Staok/buck-cc-cv/原理图-PCB-VOL.2/PCB-3D-2.png

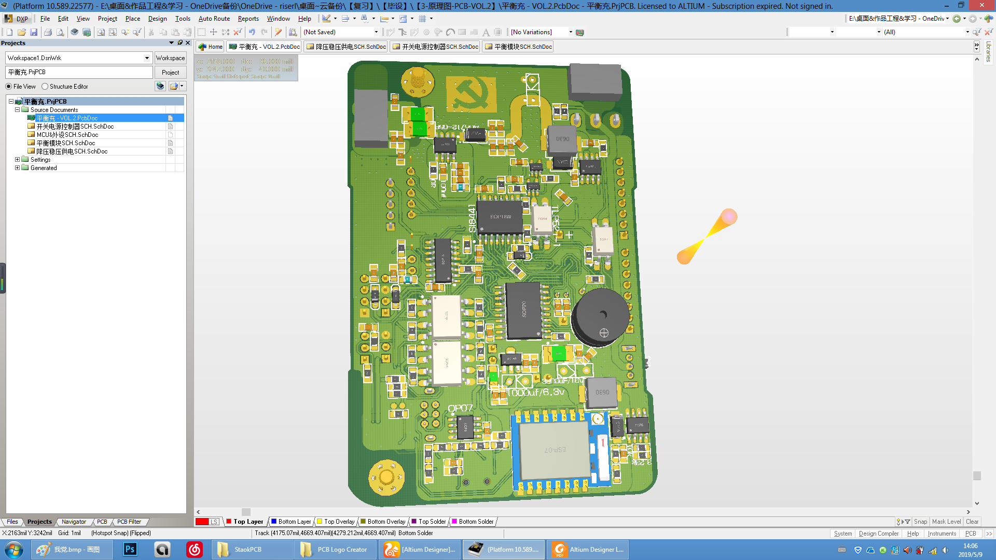
原理图-PCB-VOL.2/PCB-3D-2.png
