Staok/buck-cc-cv/README.md

# BUCK_CC-CV
 一个实现了较高质量的BUCK恒压恒流源

文件介绍：

- 程序工程：无RTOS、无GUI，STM32F1芯片，MDK5开发环境，程序架构按照“说明文件”里面的“计划.txt”做的，~~简单的一批~~，都3000多行了。
- 说明文件：包括PPT项目介绍，项目摘要，锂电池充电流程自制图，本项目硬件框架图和软件菜单设计图等。
- 原理图：原理图，随便看，我不告诉你这个原理图的电流采集部分不是真实用到的。
