Staok/buck-cc-cv/说明文件/2、电源管理方案框架示意图-VOL.2-A2.pdf

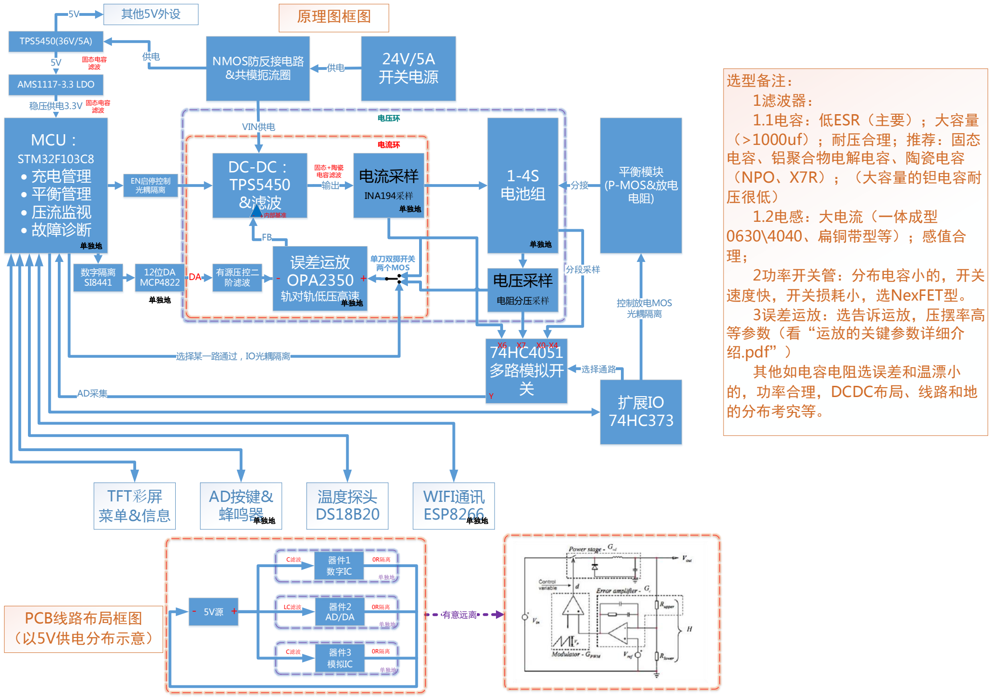
[picture p3: page 1]

选型备注：
1滤波器：
1.1电容：低ESR（主要）；大容量
（>1000uf）；耐压合理；推荐：固态
电容、铝聚合物电解电容、陶瓷电容
（NPO、X7R）；（大容量的钽电容耐
压很低）
1.2电感：大电流（一体成型
0630\4040、扁铜带型等）；感值合
理；
2功率开关管：分布电容小的，开关
速度快，开关损耗小，选NexFET型。
3误差运放：选告诉运放，压摆率高
等参数（看“运放的关键参数详细介
绍.pdf”）
其他如电容电阻选误差和温漂小
的，功率合理，DCDC布局、线路和地
的分布考究等。

PCB线路布局框图
（以5V供电分布示意）

器件1
数字IC
- 5V源 +

LC滤波

C滤波

C滤波

0R隔离

器件2
AD/DA

器件3
模拟IC

0R隔离

0R隔离

有意远离

平衡模块
(P-MOS&放电
电阻)

NMOS防反接电路
&共模扼流圈

电压采样

电阻分压采样

输出

VIN供电

供电

AD采集

电流环

TFT彩屏
菜单&信息

温度探头
DS18B20

DA

TPS5450(36V/5A)

AMS1117-3.3 LDO

稳压供电3.3V

5V

电压环

5V | 其他5V外设

24V/5A
开关电源 供电

EN启停控制
光耦隔离 | 分接

固态电容
滤波

固态电容
滤波

固态+陶瓷
电容滤波

FB

扩展IO
74HC373

控制放电MOS
光耦隔离

选择某一路通过，IO光耦隔离

DC-DC：
TPS5450

&滤波- +内部基准

数字隔离
SI8441

有源压控二
阶滤波

单刀双掷开关
两个MOS | 分段采样

74HC4051
多路模拟开
Y | 关
X6 | X7 | X0-X4

选择通路

AD按键&

蜂鸣器单独地

WIFI通讯
ESP8266单独地

MCU：

STM32F103C8
- 充电管理
- 平衡管理
- 压流监视
- 故障诊断

单独地

12位DA
MCP4822

单独地

误差运放
OPA2350
轨对轨低压高速
- +

单独地

1-4S
电池组

单独地

电流采样

INA194采样

单独地

原理图框图

单独地

单独地

单独地
