Staok/buck-cc-cv/说明文件/1、充电流程图-A2.pdf

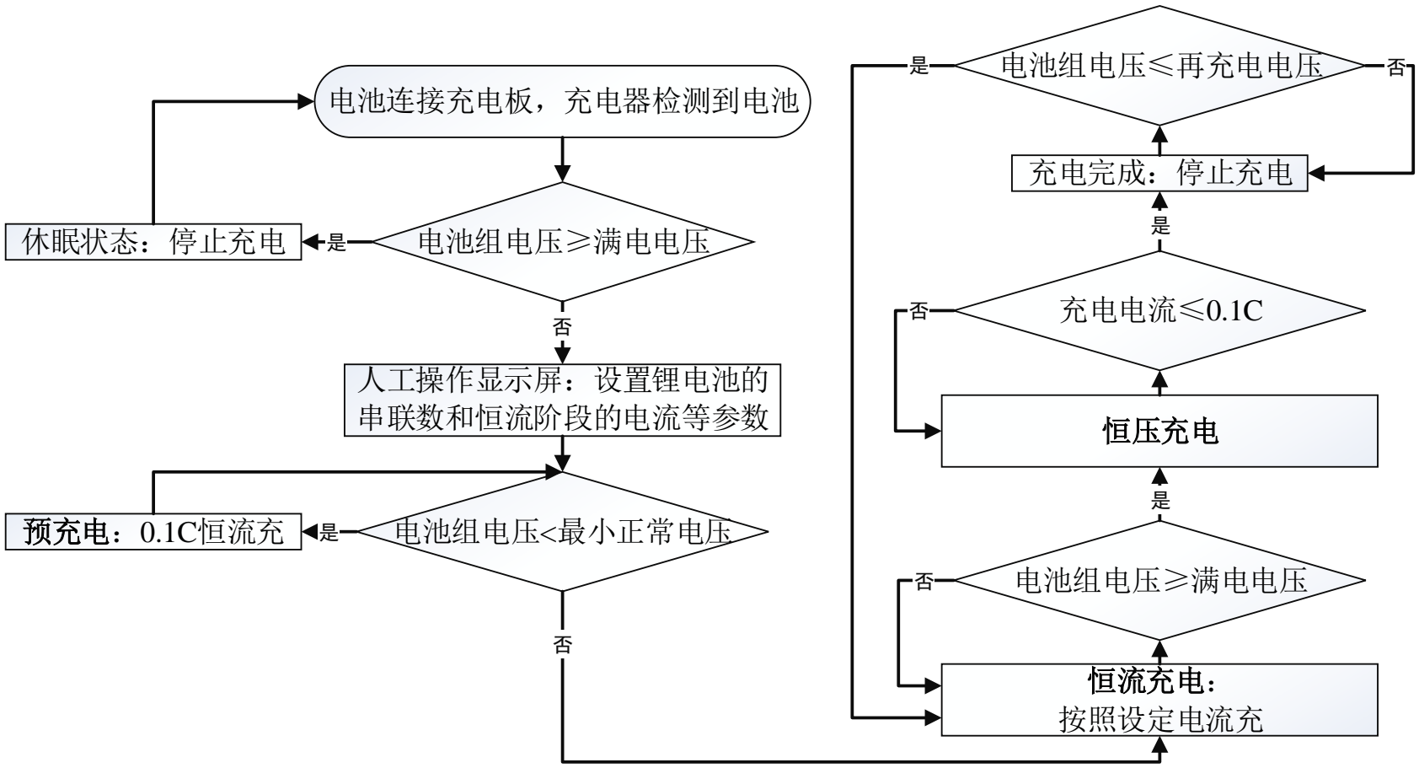
[picture p4: figure]
电池连接充电板，充电器检测到电池; 电池组电压≥满电电压; 人工操作显示屏：设置锂电池的 串联数和恒流阶段的电流等参数; 休眠状态：停止充电; 预充电：0.1C恒流充; 电池组电压<最小正常电压; 恒流充电： 按照设定电流充; 恒压充电; 充电电流≤0.1C; 充电完成：停止充电; 电池组电压≤再充电电压
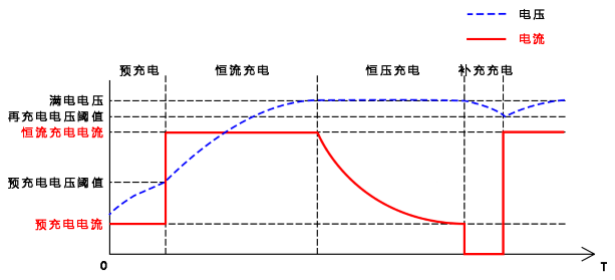
[picture p5: figure]
