Staok/buck-cc-cv/原理图-PCB-VOL.2/充电模式_小图.jpg

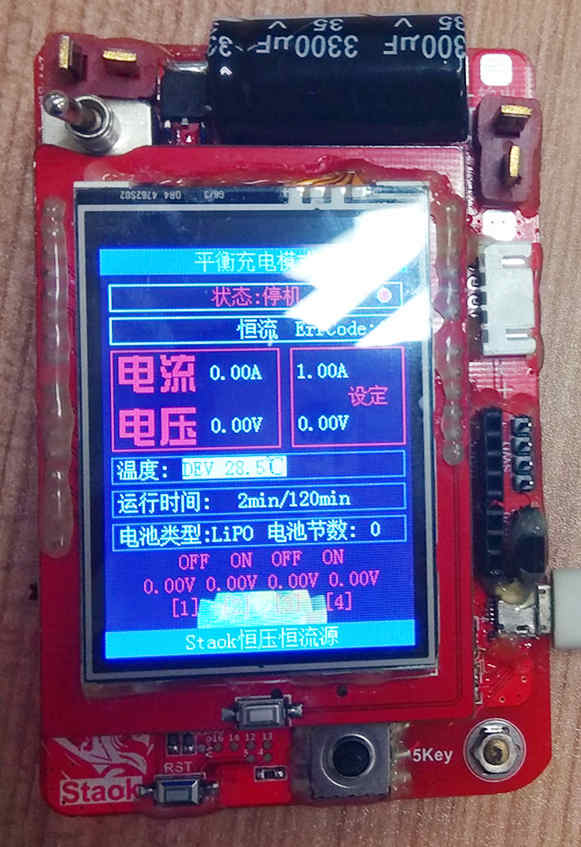
原理图-PCB-VOL.2/充电模式_小图.jpg
