Staok/buck-cc-cv/原理图-PCB-VOL.2/历史设计和其他参考/2.4寸UNO模块尺寸图.png

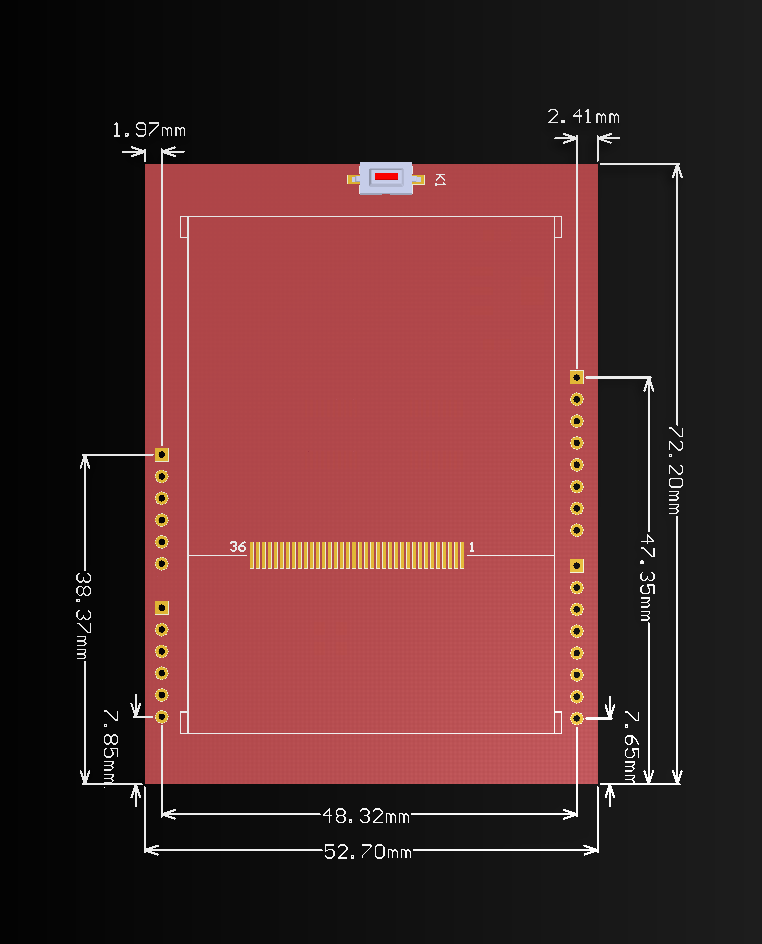
原理图-PCB-VOL.2/历史设计和其他参考/2.4寸UNO模块尺寸图.png
