Staok/buck-cc-cv/原理图-PCB-VOL.2/历史设计和其他参考/初代 vol.2.png

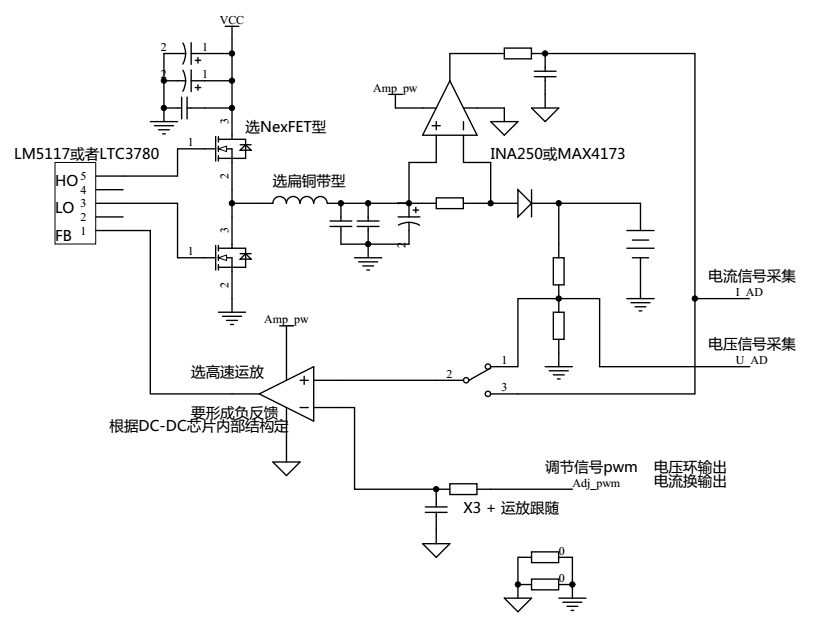
原理图-PCB-VOL.2/历史设计和其他参考/初代 vol.2.png
