Staok/buck-cc-cv/原理图-PCB-VOL.2/原理图-纠正防反接电路.png

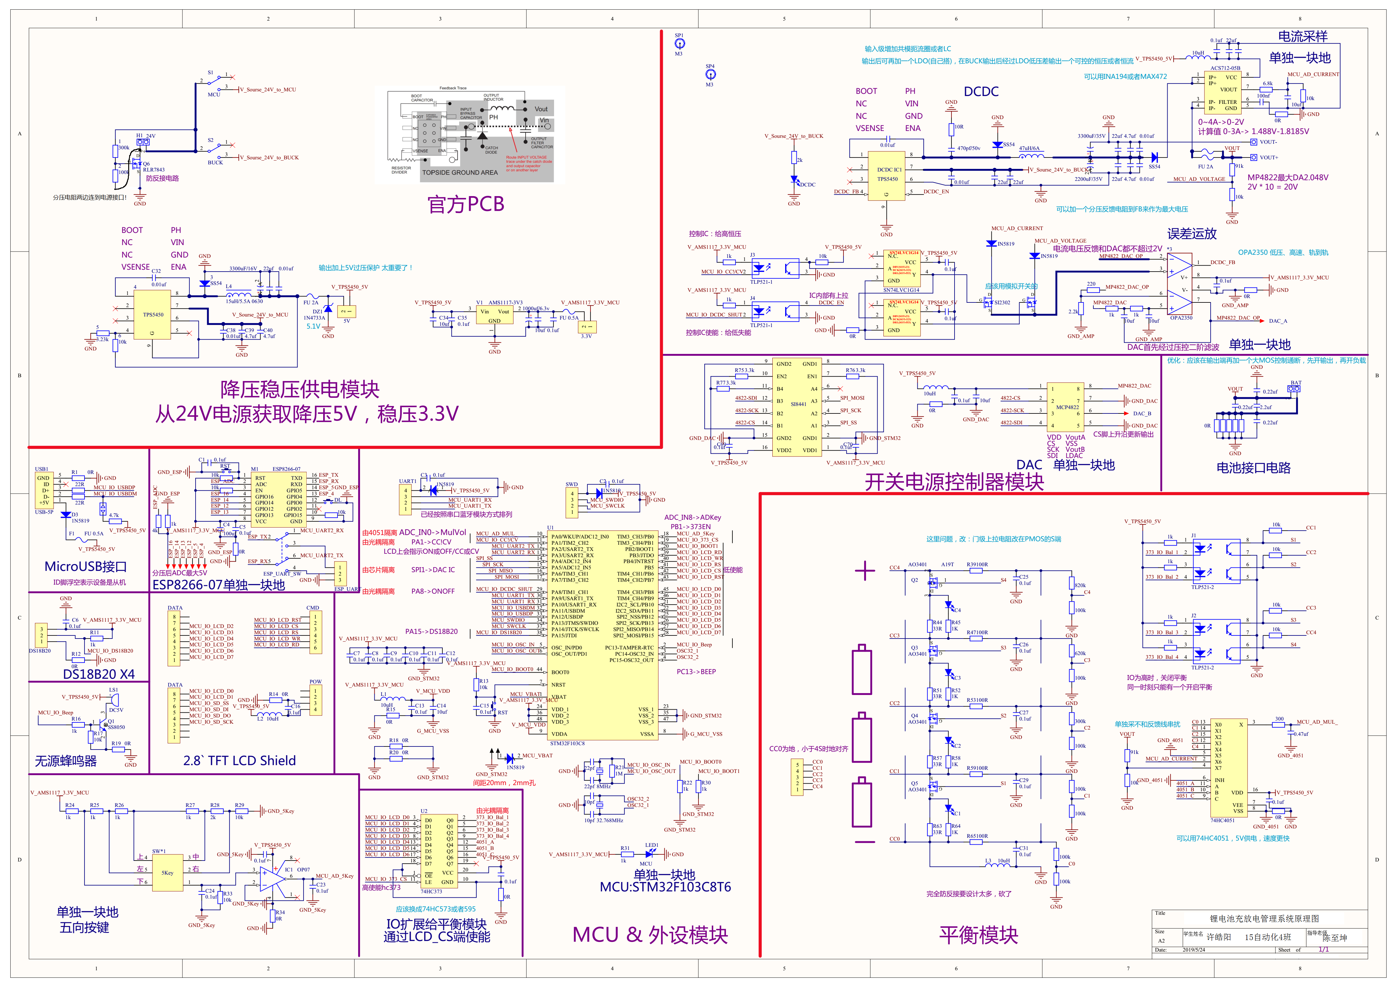
原理图-PCB-VOL.2/原理图-纠正防反接电路.png
