Staok/buck-cc-cv/说明文件/4、有源压控二阶滤波和有源一阶滤波对比-A3.png

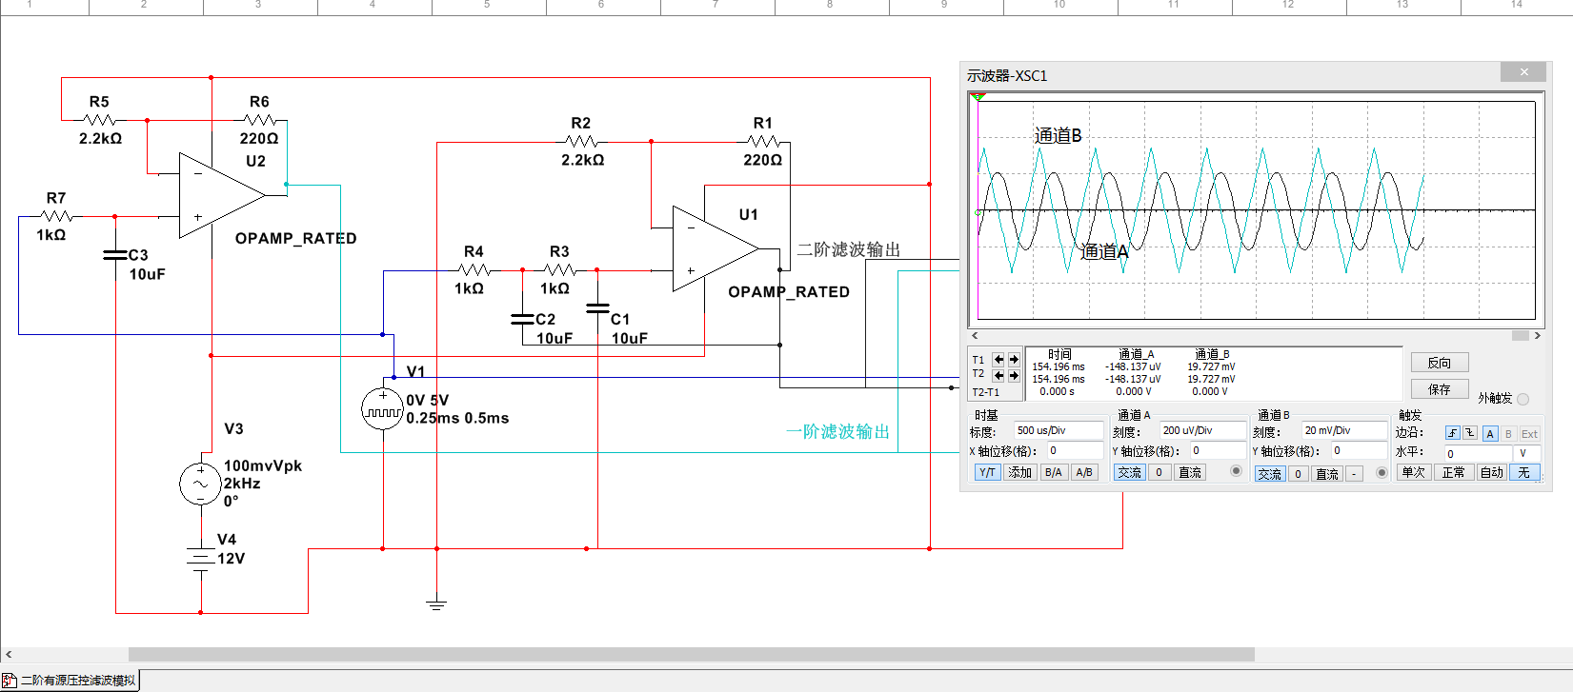
说明文件/4、有源压控二阶滤波和有源一阶滤波对比-A3.png
