Staok/buck-cc-cv/说明文件/5、菜单操作流程-A2.pdf

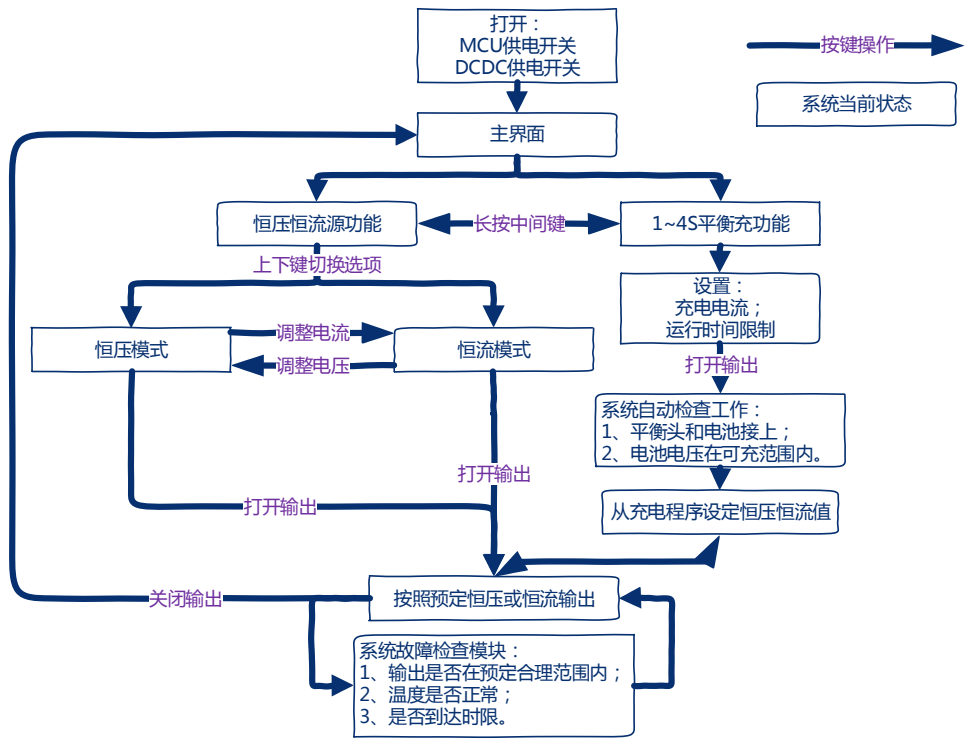
[picture p13: page 1]
打开： MCU供电开关 DCDC供电开关; 主界面; 恒压恒流源功能; 长按中间键; 1~4S平衡充功能; 恒压模式; 恒流模式; 按照预定恒压或恒流输出; 系统自动检查工作： 1、平衡头和电池接上； 2、电池电压在可充范围内。; 上下键切换选项; 调整电流; 设置： 充电电流； 运行时间限制; 调整电压; 打开输出; 系统故障检查模块： 1、输出是否在预定合理范围内； 2、温度是否正常； 3、是否到达时限。; 关闭输出; 从充电程序设定恒压恒流值; 按键操作; 系统当前状态
