Staok/buck-cc-cv/原理图-PCB-VOL.2/历史设计和其他参考/平衡充初代结构图.pdf

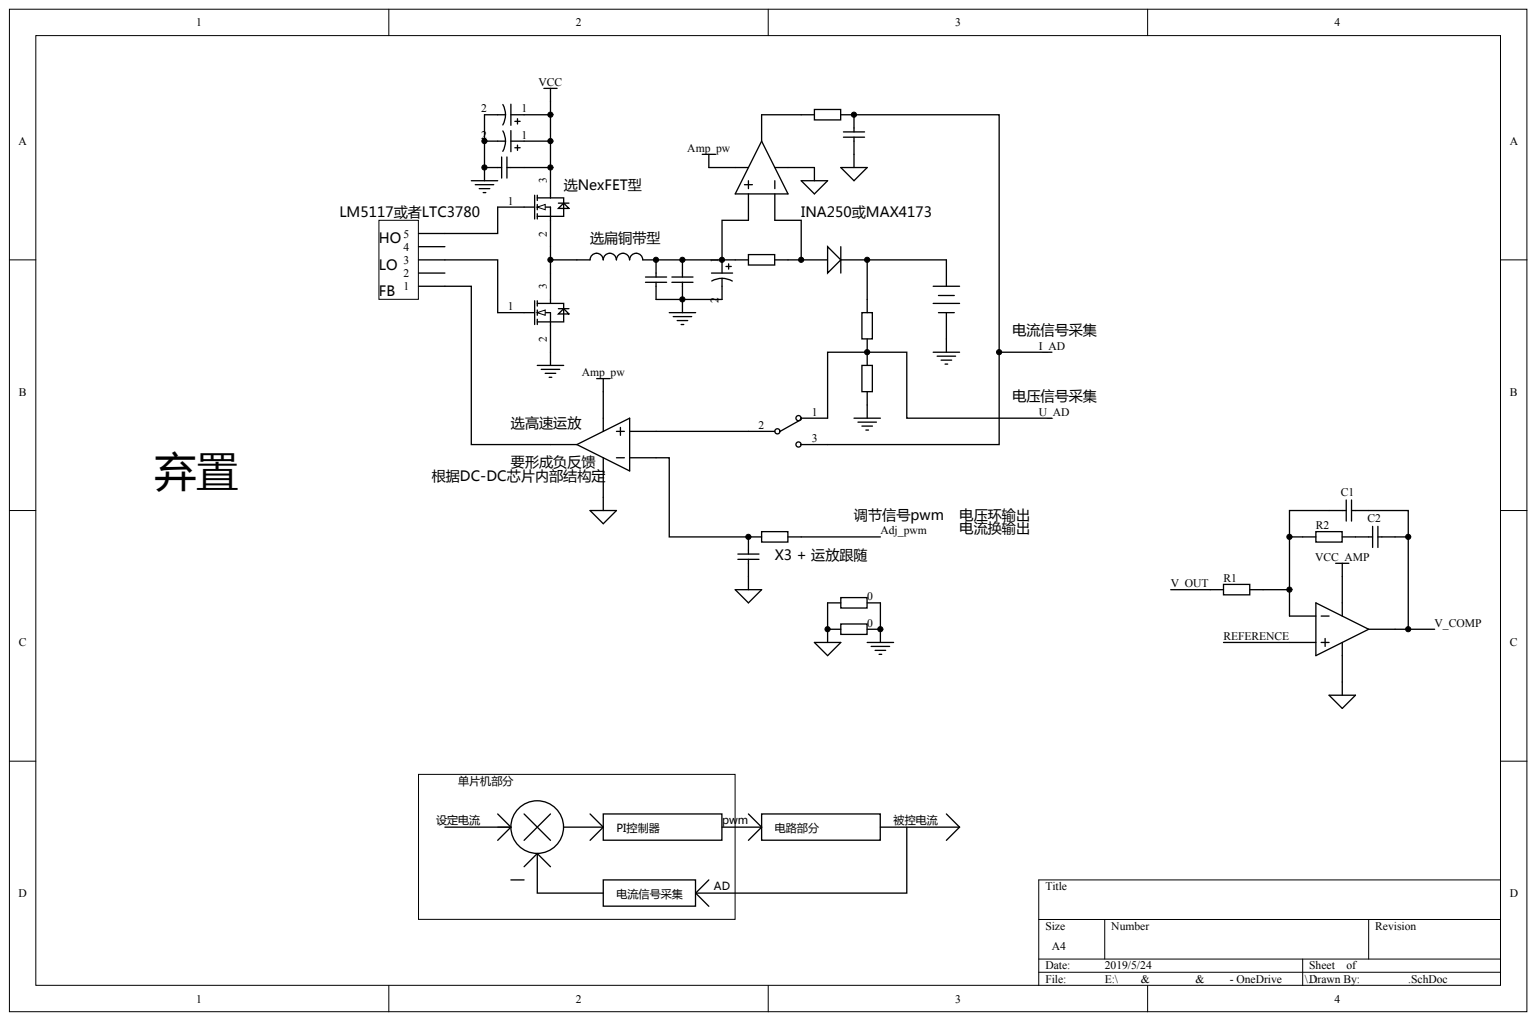
[picture p14: page 1]
