Staok/buck-cc-cv/(list of files, drawings)

Other design files:
原理图-PCB-VOL.2/MCU&外设SCH.SchDoc
原理图-PCB-VOL.2/历史设计和其他参考/平衡充初代结构图.SchDoc
原理图-PCB-VOL.2/历史设计和其他参考/开关控制器SCH.SchDoc
原理图-PCB-VOL.2/平衡模块SCH.SchDoc
原理图-PCB-VOL.2/开关电源控制器SCH.SchDoc
原理图-PCB-VOL.2/降压稳压供电SCH.SchDoc
