Staok/buck-cc-cv/程序工程/HARDWARE/ADC/adc.c

 #include "adc.h"
 #include "delay.h"
//////////////////////////////////////////////////////////////////////////////////	 
//本程序只供学习使用，未经作者许可，不得用于其它任何用途
//Mini STM32开发板
//ADC 驱动代码			   
//正点原子@ALIENTEK
//技术论坛:www.openedv.com
//修改日期:2010/6/7 
//版本：V1.0
//版权所有，盗版必究。
//Copyright(C) 正点原子 2009-2019
//All rights reserved					   
//////////////////////////////////////////////////////////////////////////////////	 
 
		   
//初始化ADC，学一学ADC->DMA多省时间
//这里我们仅以规则通道为例
//我们默认将开启通道0~3																	   
void  Adc_Init(void)
{ 	
	ADC_InitTypeDef ADC_InitStructure; 
	GPIO_InitTypeDef GPIO_InitStructure;
	RCC_APB2PeriphClockCmd(RCC_APB2Periph_GPIOA | RCC_APB2Periph_GPIOB | RCC_APB2Periph_ADC1, ENABLE );//使能ADC1通道时钟
 
	RCC_APB2PeriphResetCmd(RCC_APB2Periph_ADC1,ENABLE);	//ADC1复位
	RCC_APB2PeriphResetCmd(RCC_APB2Periph_ADC1,DISABLE);//ADC1复位借宿

	RCC_ADCCLKConfig(RCC_PCLK2_Div6);   //72M/6=12,ADC最大时间不能超过14M
	//PA0 作为模拟通道输入引脚                         
	GPIO_InitStructure.GPIO_Pin = GPIO_Pin_0;
	GPIO_InitStructure.GPIO_Mode = GPIO_Mode_AIN;		//模拟输入引脚
	GPIO_Init(GPIOA, &GPIO_InitStructure);
    //PB0 作为模拟通道输入引脚
    GPIO_InitStructure.GPIO_Pin = GPIO_Pin_0;
    GPIO_InitStructure.GPIO_Mode = GPIO_Mode_AIN;//PB0对应ADKey
    GPIO_Init(GPIOB, &GPIO_InitStructure);

	ADC_DeInit(ADC1);  //将外设 ADC1 的全部寄存器重设为缺省值

	ADC_InitStructure.ADC_Mode = ADC_Mode_Independent;	//ADC工作模式:ADC1工作在独立模式
	ADC_InitStructure.ADC_ScanConvMode = DISABLE;	//模数转换工作在单通道模式
	ADC_InitStructure.ADC_ContinuousConvMode = DISABLE;	//模数转换工作在单次转换模式
	ADC_InitStructure.ADC_ExternalTrigConv = ADC_ExternalTrigConv_None;	//转换由软件而不是外部触发启动
	ADC_InitStructure.ADC_DataAlign = ADC_DataAlign_Right;	//ADC数据右对齐
	ADC_InitStructure.ADC_NbrOfChannel = 1;	//顺序进行规则转换的ADC通道的数目
	ADC_Init(ADC1, &ADC_InitStructure);	//根据ADC_InitStruct中指定的参数初始化外设ADCx的寄存器   

  //	ADC_RegularChannelConfig(ADC1, ADC_Channel_1, 1, ADC_SampleTime_239Cycles5);  //ADC规则序列配置
    ADC_TempSensorVrefintCmd(ENABLE); //开启内部温度传感器
	ADC_Cmd(ADC1, ENABLE);	//使能指定的ADC1
    
	ADC_ResetCalibration(ADC1);	//重置指定的ADC1的校准寄存器
	while(ADC_GetResetCalibrationStatus(ADC1));	//获取ADC1重置校准寄存器的状态,设置状态则等待
	ADC_StartCalibration(ADC1);		//开始指定ADC1的校准状态
	while(ADC_GetCalibrationStatus(ADC1));		//获取指定ADC1的校准程序,设置状态则等待
	//ADC_SoftwareStartConvCmd(ADC1, ENABLE);		//使能指定的ADC1的软件转换启动功能

}				  
//获得ADC值
//ch:通道值 0~3
u16 Get_Adc(u8 ch)   
{
  	//设置指定ADC的规则组通道，设置它们的转化顺序和采样时间
	ADC_RegularChannelConfig(ADC1, ch, 1, ADC_SampleTime_239Cycles5 );	//ADC1,ADC通道,规则采样顺序值为1,采样时间为239.5周期
	ADC_SoftwareStartConvCmd(ADC1, ENABLE);		//使能指定的ADC1的软件转换启动功能	
	while(!ADC_GetFlagStatus(ADC1, ADC_FLAG_EOC ));//等待转换结束
	return ADC_GetConversionValue(ADC1);	//返回最近一次ADC1规则组的转换结果
}

u16 Get_Adc_Average(u8 ch,u8 times)
{
	u32 temp_val=0;
	u8 t;
	for(t=0;t<times;t++)
	{
		temp_val+=Get_Adc(ch);
		delay_ms(2);
	}
	return temp_val/times;
} 	 
