Staok/buck-cc-cv/(commit log)

2020-03-26 首次提交，真JI麻烦
    [MCU&外设SCH.SchDoc, 平衡充初代结构图.SchDoc, 平衡模块SCH.SchDoc, 开关控制器SCH.SchDoc, 开关电源控制器SCH.SchDoc, 数据拟合.xlsx, 降压稳压供电SCH.SchDoc]
2020-03-26 加了点东西
2020-06-21 加一点注释，其它无修改
2021-09-16 上传纠正电路
