Staok/buck-cc-cv/(notices)

Notices in the files:
程序工程/SYSTEM/usart/usart.c:
Copyright(C) ¹ãÖÝÊÐÐÇÒíµç×Ó¿Æ¼¼ÓÐÏÞ¹«Ë¾ 2009-2019
All rights reserved
程序工程/HARDWARE/LCD/GUI.c:
Copyright(C) ÉîÛÚÊÐÈ«¶¯µç×Ó¼¼ÊõÓÐÏÞ¹«Ë¾ 2009-2019
程序工程/HARDWARE/ITEMP/tsensor.c:
Copyright(C) ÕýµãÔ­×Ó 2009-2019
